techstudycell/IoT-Project-with-ESP32-Blynk-Timer-Sensor/Circuit/Circuit of esp32 control relay p6.png

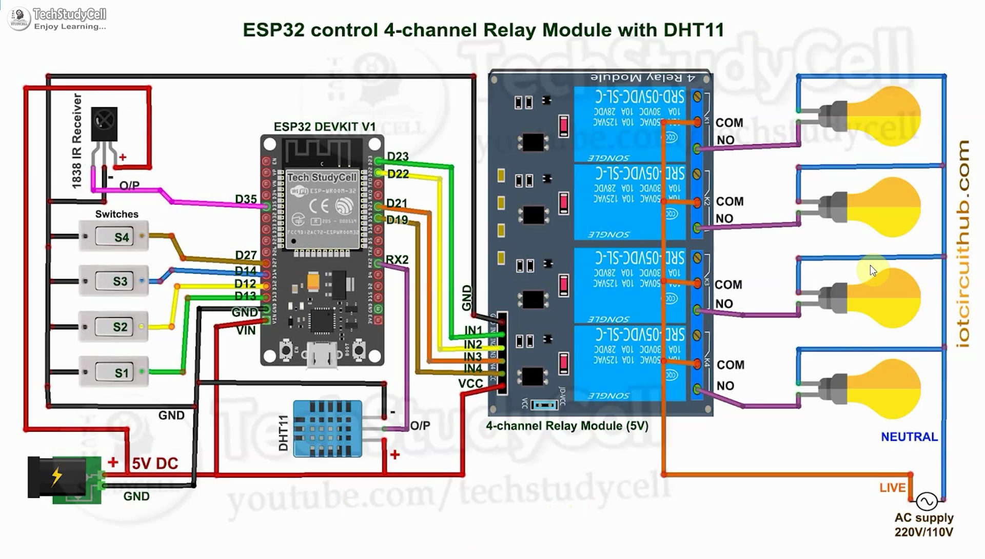
Circuit/Circuit of esp32 control relay p6.png
