techstudycell/IoT-Project-with-ESP32-Blynk-Timer-Sensor/Picture/iot project with esp32 p2.png

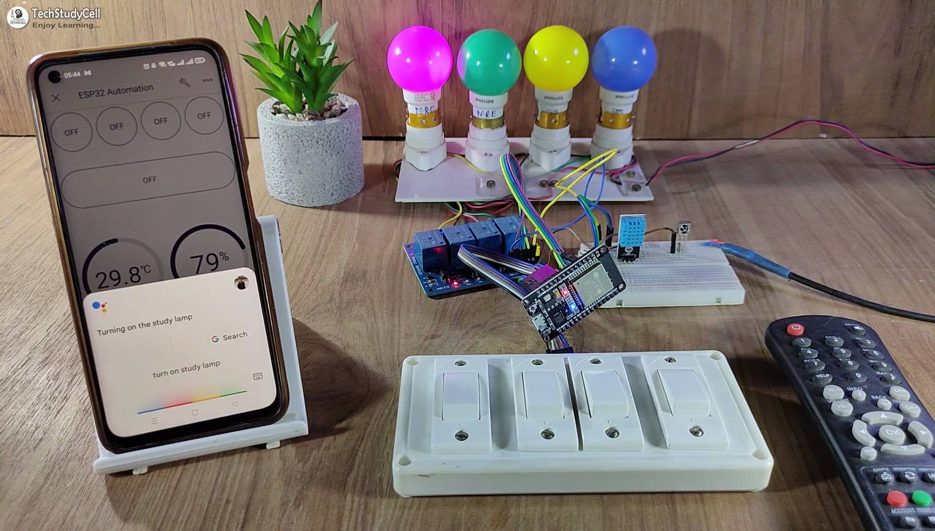
Picture/iot project with esp32 p2.png
