techstudycell/IoT-Project-with-ESP32-Blynk-Timer-Sensor/Picture/iot project with esp32 p11.png

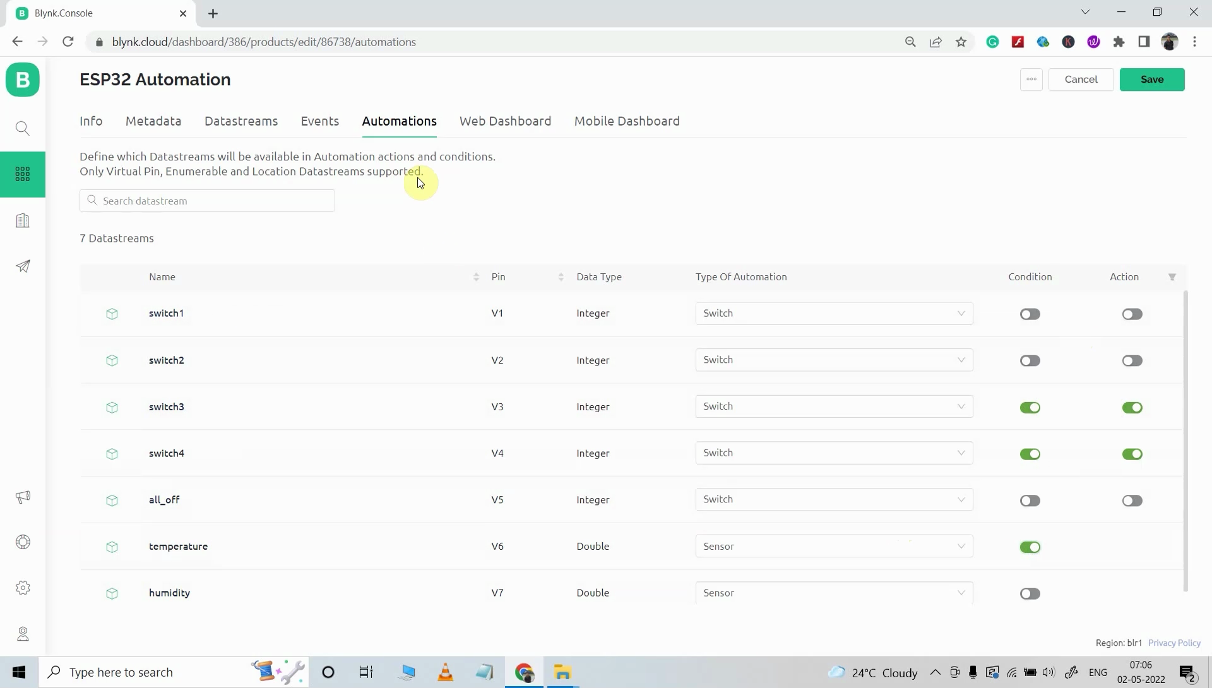
Picture/iot project with esp32 p11.png
