techstudycell/IoT-Project-with-ESP32-Blynk-Timer-Sensor/PCB_Gerber/BOM_PCB_ESP32_Relay_SMT_V1_F1_2022-04-30.csv

ID | Name | Designator | Footprint | Quantity | Manufacturer Part | Manufacturer | Supplier | Supplier Part | Price
1 | SS8050_C181160 | Q2,Q3,Q4,Q1 | SOT-23-3_L2.9-W1.6-P1.90-LS2.8-BR | 4 | SS8050 | Hottech | LCSC | C181160 | 0.011
2 | 1K | R1,R2,R3,R4,R5,R6,R7,R8,R9,R10,R11,R12 | R0603 | 12 | RC0603JR-071KL | YAGEO | LCSC | C14676 | 0.001
3 | SS-12D10-G050 | SW9 | SW-TH_SS-12D10-G050 | 1 | SS-12D10-G050 | G-Switch(品赞) | LCSC | C2848933 | 0.223
4 | 220uF | C1 | CAP-TH_BD5.0-P2.00-D0.8-FD | 1 | 220uF 10V black gold 5*11 | ValuePro | LCSC | C43355 | 0.016
5 | M7_C392013 | D1,D2,D4,D5 | SMA_L4.4-W2.6-LS5.0-RD | 4 | M7 | Guangdong Hottech | LCSC | C392013 | 0.007
6 | MH254V-11-03-1000 | DHT,IR_RCV | HDR-TH_3P-P2.54-V-M-3 | 2 | MH254V-11-03-1000 | XFCN(台湾兴飞) | LCSC | C2844842 | 0.096
7 | MH254V-11-06-1000 | H1 | HDR-TH_6P-P2.54-V-M-3 | 1 | MH254V-11-06-1000 | XFCN(台湾兴飞) | LCSC | C2844841 | 0.144
8 | MH254V-11-08-1000 | H2 | HDR-TH_8P-P2.54-V-M | 1 | MH254V-11-08-1000 | XFCN(台湾兴飞) | LCSC | C2889983 | 0.181
9 | MH254V-11-02-1000 | H3 | HDR-TH_2P-P2.54-V-M | 1 | MH254V-11-02-1000 | XFCN(台湾兴飞) | LCSC | C2889980 | 0.051
10 | MH254V-11-04-1000 | H4 | HDR-TH_4P-P2.54-V-M-3 | 1 | MH254V-11-04-1000 | XFCN | LCSC | C509261 | 0.099
11 | 17-21SURC/S530-A3/TR8 | LED1,LED2,LED3,LED4,LED5,LED6,LED7,LED8 | LED0805-R-RD | 8 | 17-21SURC/S530-A3/TR8 | EVERLIGHT | LCSC | C72037 | 0.016
12 | WJ126V-5.0-2P | P1,P2,P3,P4,P5 | CONN-TH_WJ126V-5.0-2P | 5 | WJ126V-5.0-2P | ReliaPro | LCSC | C8404 | 0.074
13 | 10kΩ | R18,R19 | R0402 | 2 | AS02FTE1002 | Viking Tech | LCSC | C304153 | 0.002
14 | SRD-05VDC-SL-C | RLY1,RLY2,RLY3,RLY4 | RELAY-TH_SRD-XXVDC-XL-C | 4 | SRD-05VDC-SL-C | SONGLE | LCSC | C35449 | 0.51
15 | UK-B0202-G5.5-250 | SW1,SW2,SW3,SW4,SW5,SW6,SW7,SW8 | SW-TH_4P-L6.0-W6.0-P4.50-LS6.5 | 8 | UK-B0202-G5.5-250 | USAKRO | LCSC | C620156 | 0.039
16 | ORPC-817C | U1,U2,U3,U4 | DIP-4_L6.4-W4.6-P2.54-LS7.6-BL | 4 | - | Orient | LCSC | C231239 | 0.043
17 | HLK-5M05 | U5 | PWRM-TH_HLK-5M05 | 1 | HLK-5M05 | HI-LINK | LCSC | C209907 | 2.997
18 | AMS1117-3.3 | U6 | SOT-223-3_L6.5-W3.4-P2.30-LS7.0-BR | 1 | AMS1117-3.3 | AMS | LCSC | C6186 | 0.15
19 | ESP32-WROOM-32D | U7 | WIFIM-SMD_39P-L25.5-W18.0-P1.27-BL | 1 | ESP32-WROOM-32D | ESPRESSIF 乐鑫 | LCSC | C473012 | 3.823
